mboroff/PatriotAllianceMod_1_2_PA3ANG_WD9GYM/IMG_4692.JPG

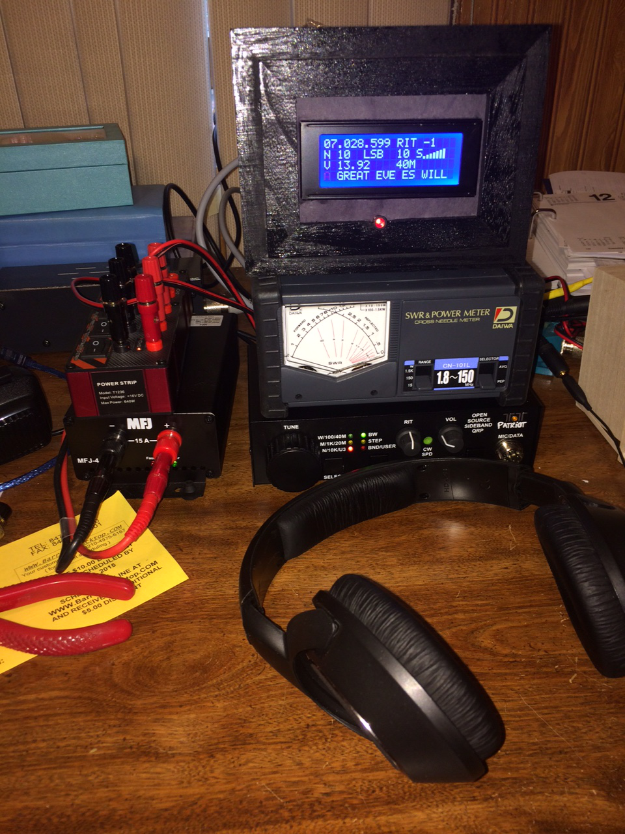
IMG_4692.JPG
