mboroff/PatriotAllianceMod_1_2_PA3ANG_WD9GYM/README.md

# PatriotAllianceMod_1_2_PA3ANG_WD9GYM
Ten Tec Patriot Alliance Mod for Morse Code Dcoding

This project contains the documnetation and software for modifing the Patriot to decode Morse code.
