mboroff/PatriotAllianceMod_1_2_PA3ANG_WD9GYM/fritzimage.jpg

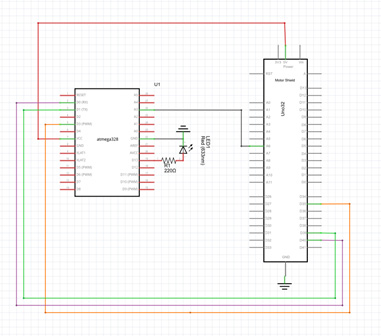
fritzimage.jpg
