mboroff/PatriotAllianceMod_1_2_PA3ANG_WD9GYM/test results.txt

80 wpm -->c,60ct6 ,xe4c727 y1d2tbex 6,xb 69 y 7?1qj119 3c?1b 7, h 1xpxg9 rg4x7 q 7 2d v8jq eh2lc5.c 6bx9t8 1x 9d8 bf1z 4c 1 35d5?2o4 8zg ?d .6x46, 7v/? 8bc 21cfx z75d
decode -->M R  R  NR  BO Y G? 5 D Z, H Q #Q  KI W S    I SDEJC DEBKIH    4C 1 35DH#2O4 8ZG ?D .6X46MM 7V/? 8BC 21CFX M ME5D

70 wpm -->hox7xn/ c9q 7eh?x6 /c?  x,6??6x 47 d041? 8xc4d, 8 20h8h4 1 0,h4bc5 6bed/ 2y7d1x 66qz? p?c924 7cx xq z4zhex 4 2?x/
decode --> TO      C9Q 7EH?X6 /C? X,6??6X 47  41?  8XC4D, 8 20H8H4 1 0,   BC5 6BED/ 2Y7D1X 66QZ? P?C924 7CX XQ Z4ZHEX 4 2?X/

65 wpm -->w x5 .0b8xqwb x d925o6 .xg1tf4 vy 6x11bdnx . xid drxzf8a0 6cxqdq61 742vx672 814qh pe xf3, xd/dy1g xxiz9b28 y c c72ecxd5 c66j 
decoded-->                WB X D925O6 .XG1TF4 VY 6X    .         DRXZF8A0 6 Q 61   742VX  2 814QH PE XF  XD/DY1G XXIZ9 8 Y C C72ECXD5 C6

60 wpm -->   6?52ix 6 7qjh gdd4 xc1c cz j 4ch5q, 86ed7 /2 1ed2 bbc2hw 61x/c6l x 74 x3dgx y5d657j4 q3x6dc9c 36z3x4zz xd3hh 9b
decoded --> 6?52IX 6 7QJH GD  XC1C CZ J 4CH5  86ED7 /2 1ED2 BBC2HW 61X/C6L X 74 X3DGX Y5D J4 Q3X6DC9C 36Z3X4ZZ X HH 9B
