mboroff/PatriotAllianceMod_1_2_PA3ANG_WD9GYM/(list of files, drawings)

Other design files:
decoder.fzz
